Ccecil/Flambehub/Flambehub_0.2_1.jpg

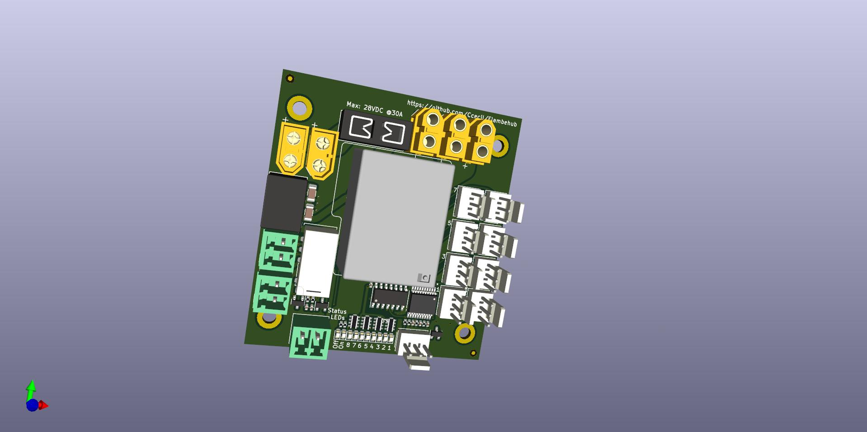
Flambehub_0.2_1.jpg
