Ccecil/Flambehub/Flambehub_0.2_1_back.jpg

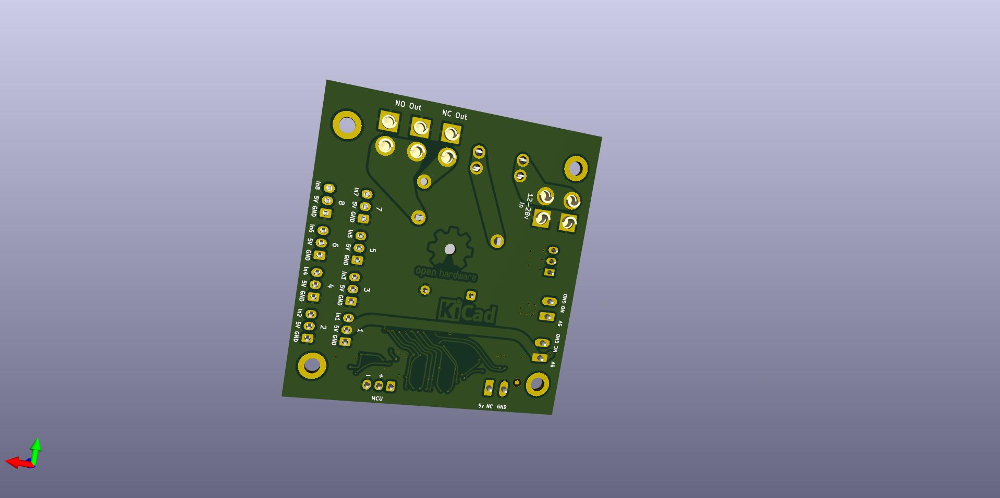
Flambehub_0.2_1_back.jpg
