Ccecil/Flambehub/Flambehub_0.2.pdf

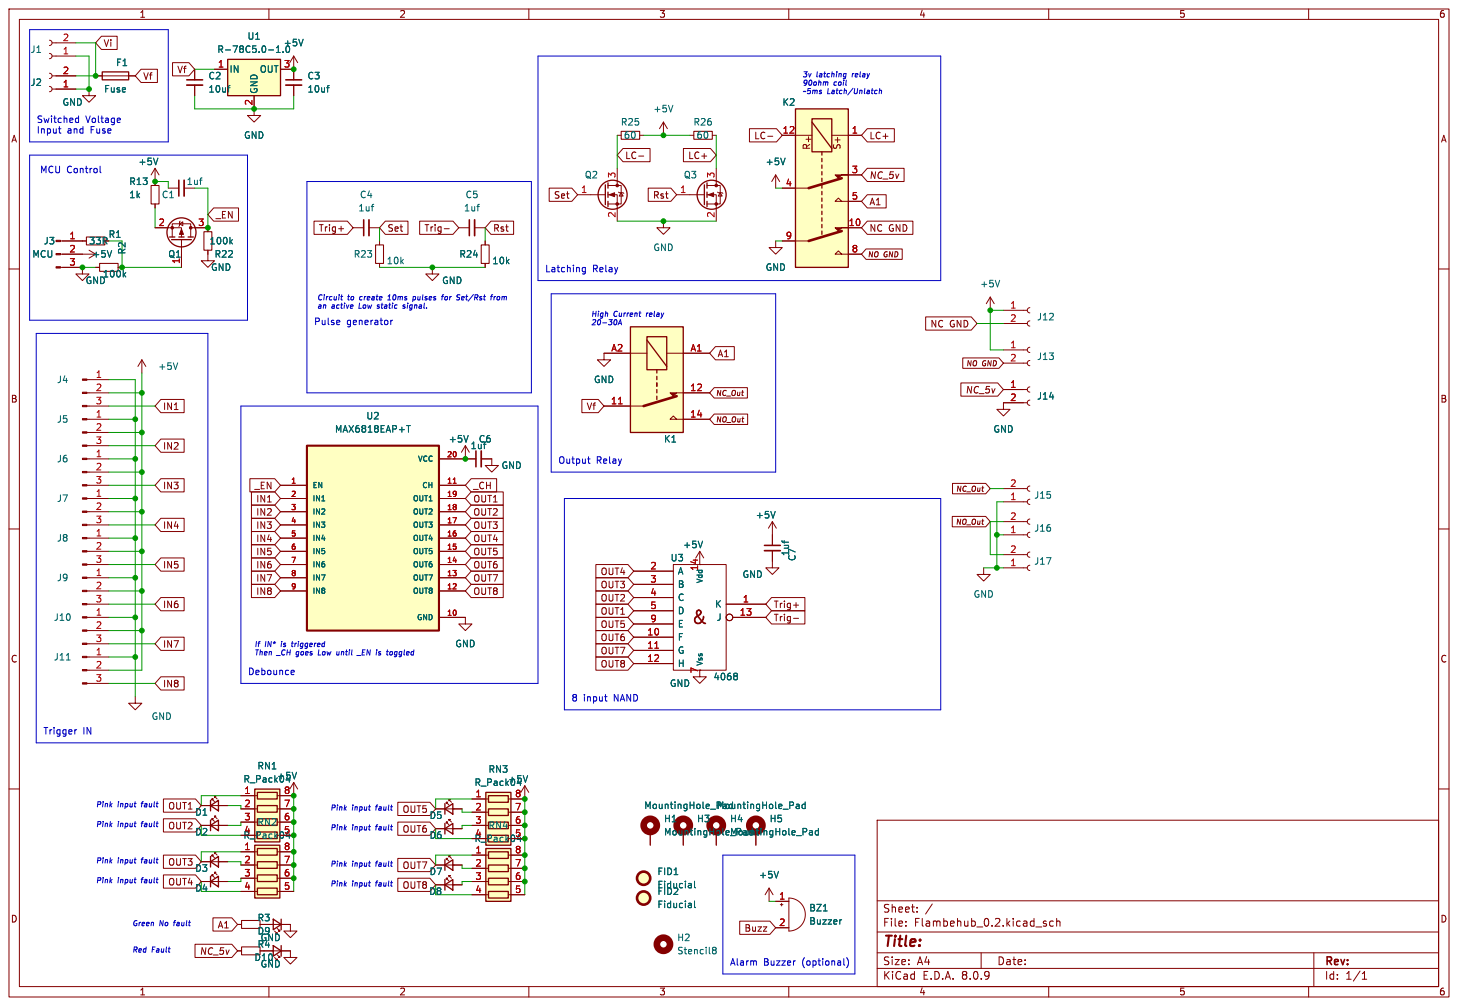
[picture p3: page 1]

an active Low static signal.

Id: 1/1 Title: File: Flambehub_0.2.kicad_sch Sheet: /
