Ccecil/Flambehub/Flambehub_0.2.kicad_pcb

## KiCad design Flambehub_0.2.kicad_pcb (2023-11-13)

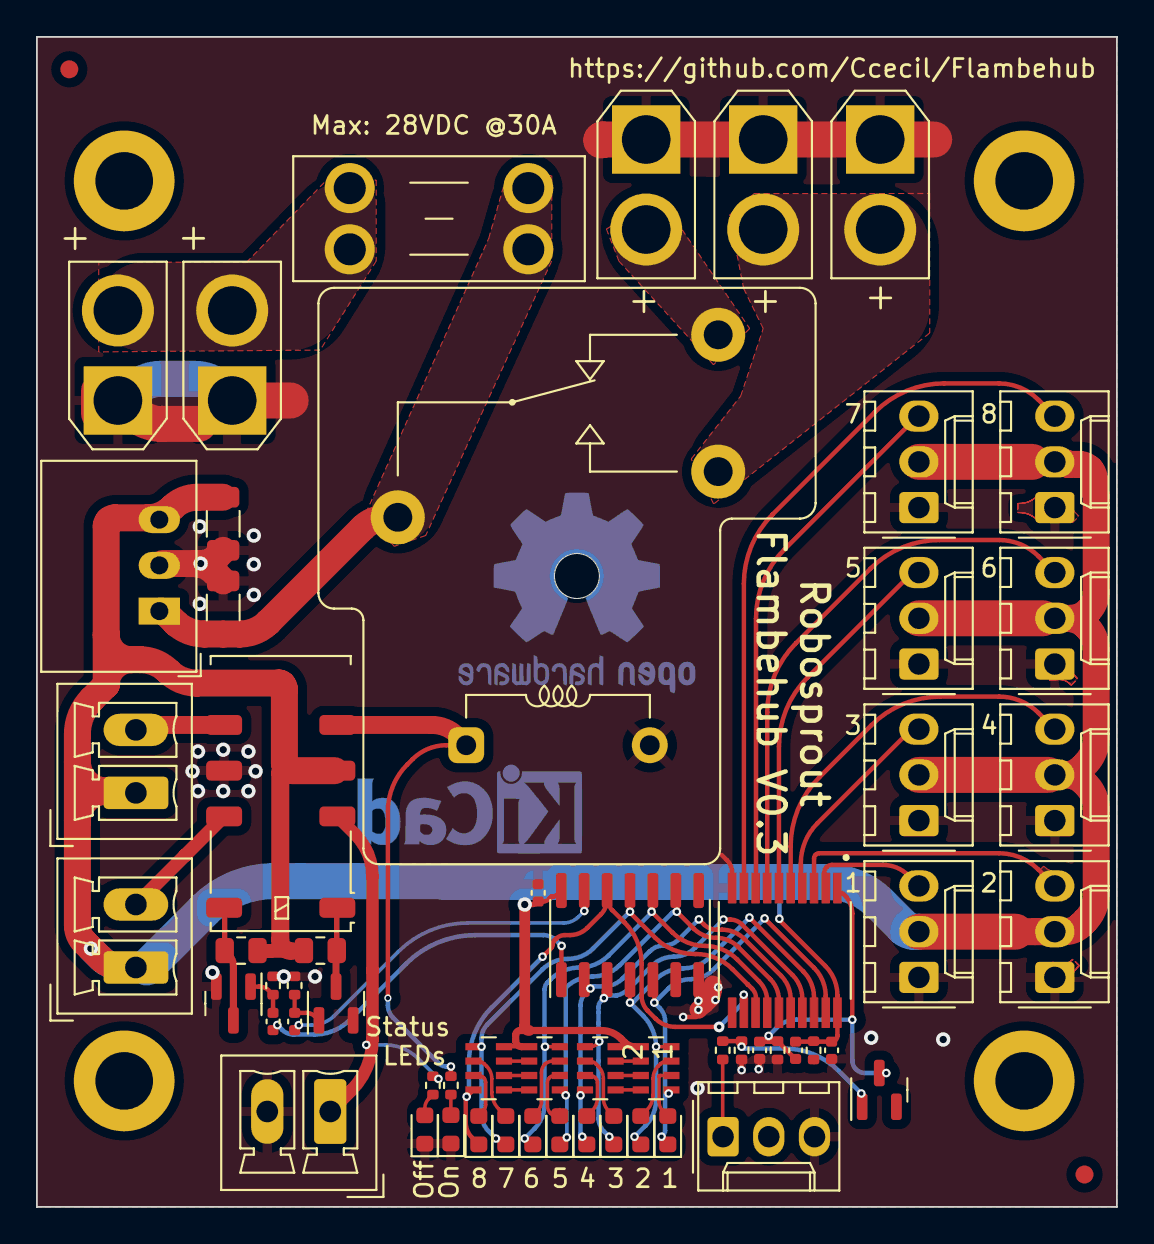
[picture p4: board Flambehub_0.2.kicad_pcb from above]

Board: 2 copper layers, 60.0 x 65.0 mm, 66 parts (1 on the bottom side), 46 nets.

Parts:
C1, C1#2, C4, C5, C6, C7: 1uf; C_0402_1005Metric
C2, C3: 10uf; C_1206_3216Metric
D1, D2, D3, D4, D5, D6, D7, D8, D9, D10: LED_Small; LED_0603_1608Metric
F1: Fuse; Fuseholder_Blade_Mini_Keystone_3568
FID1, FID2, FID3: Fiducial; Fiducial_1mm_Mask2mm
H1, H3, H4, H5: MountingHole_Pad; MountingHole_3.2mm_M3_DIN965_Pad
H2: Stencil8; MountingHole_2.5mm
J1, J2, J15, J16, J17: Conn_01x02_Female; AMASS_XT30U-F_1x02_P5.0mm_Vertical
J3: MCU; Molex_KK-254_AE-6410-03A_1x03_P2.54mm_Vertical
J4, J5, J6, J7, J8, J9, J10, J11: Conn_01x03_Male; Molex_KK-254_AE-6410-03A_1x03_P2.54mm_Vertical
J12, J13, J14: Conn_01x02_Female; PhoenixContact_MCV_1,5_2-G-3.5_1x02_P3.50mm_Vertical
K1: RAYEX-L90S; Relay_SPDT_RAYEX-L90S
K2: 5-1462037-4; Relay_DPDT_Kemet_EE2_NUH
Q1: BSS84; SOT-23
Q2, Q3: 2N7002; SOT-23
R1: 33R; R_0402_1005Metric
R2, R22: 100k; R_0402_1005Metric
R3, R4, R23, R24: 10k; R_0402_1005Metric
R13: 1k; R_0402_1005Metric
R25, R26: 60; R_0805_2012Metric
RN1, RN2, RN3, RN4: R_Pack04; R_Array_Concave_4x0603
U1: MAX6818EAP+T; SOP65P777X199-20N
U1#2: R-78C5.0-1.0; Converter_DCDC_RECOM_R-78E-0.5_THT
U3: 4068; SOIC-14_3.9x8.7mm_P1.27mm

Connections:
+5V: C1#2.1, C3.1, C6.1, C7.1, J3.2, J4.2, J5.2, J6.2, J7.2, J8.2, J9.2, J10.2, J11.2, J12.1, J13.1, K2.4, R13.1, R25.2, R26.1, RN1.5 (R4.2), RN1.6 (R3.2), RN1.7 (R2.2), RN1.8 (R1.2), RN2.5 (R4.2), RN2.6 (R3.2), RN2.7 (R2.2), RN2.8 (R1.2), RN3.5 (R4.2), RN3.6 (R3.2), RN3.7 (R2.2), RN3.8 (R1.2), RN4.5 (R4.2), RN4.6 (R3.2), RN4.7 (R2.2), RN4.8 (R1.2), U1.20 (VCC), U1#2.3 (OUT), U3.14 (Vdd)
A1: K1.A1, K2.5, R3.2
GND: C1.2, C2.2, C3.2, C6.2, C7.2, D9.1 (K), D10.1 (K), J1.1, J2.1, J3.3, J4.1, J5.1, J6.1, J7.1, J8.1, J9.1, J10.1, J11.1, J14.2, J15.1, J16.1, J17.1, K1.A2, K2.9, Q2.2 (S), Q3.2 (S), R2.2, R22.1, R23.2, R24.2, U1.10 (GND), U1#2.2 (GND), U3.7 (Vss)
IN1: J4.3, U1.2 (IN1)
IN2: J5.3, U1.3 (IN2)
IN3: J6.3, U1.4 (IN3)
IN4: J7.3, U1.5 (IN4)
IN5: J8.3, U1.6 (IN5)
IN6: J9.3, U1.7 (IN6)
IN7: J10.3, U1.8 (IN7)
IN8: J11.3, U1.9 (IN8)
LC+: K2.1, Q3.3 (D), R26.2
LC-: K2.12, Q2.3 (D), R25.1
NC GND: J12.2, K2.10
NC_5v: J14.1, K2.3, R4.2
NC_Out: J15.2, K1.12
NO GND: J13.2, K2.8
NO_Out: J16.2, J17.2, K1.14
unnamed: D1.2 (A), RN1.2 (R2.1)
unnamed: D2.2 (A), RN1.3 (R3.1)
unnamed: D3.2 (A), RN2.2 (R2.1)
unnamed: D4.2 (A), RN2.3 (R3.1)
unnamed: D5.2 (A), RN3.2 (R2.1)
unnamed: D6.2 (A), RN3.3 (R3.1)
unnamed: D7.2 (A), RN4.2 (R2.1)
unnamed: D8.2 (A), RN4.3 (R3.1)
unnamed: D9.2 (A), R3.1
unnamed: D10.2 (A), R4.1
unnamed: J3.1, R1.1
unnamed: Q1.1 (G), R1.2, R2.1
unnamed: Q1.2 (S), R13.2
OUT1: D1.1 (K), RN1.1 (R1.1), U1.19 (OUT1), U3.5 (D)
OUT2: D2.1 (K), RN1.4 (R4.1), U1.18 (OUT2), U3.4 (C)
OUT3: D3.1 (K), RN2.1 (R1.1), U1.17 (OUT3), U3.3 (B)
OUT4: D4.1 (K), RN2.4 (R4.1), U1.16 (OUT4), U3.2 (A)
OUT5: D5.1 (K), RN3.1 (R1.1), U1.15 (OUT5), U3.9 (E)
OUT6: D6.1 (K), RN3.4 (R4.1), U1.14 (OUT6), U3.10 (F)
OUT7: D7.1 (K), RN4.1 (R1.1), U1.13 (OUT7), U3.11 (G)
OUT8: D8.1 (K), RN4.4 (R4.1), U1.12 (OUT8), U3.12 (H)
Rst: C5.2, Q3.1 (G), R24.1
Set: C4.2, Q2.1 (G), R23.1
Trig+: C4.1, U3.1 (K)
Trig-: C5.1, U3.13 (J)
Vf: C2.1, F1.1, K1.11, U1#2.1 (IN)
Vi: F1.2, J1.2, J2.2
_EN: C1.1, C1#2.2, Q1.3 (D), R22.2, U1.1 (EN)
